augustolnb/Holhooja/projeto-holhooja/docs/obsidian_notes/Pasted image 20240227125910.png

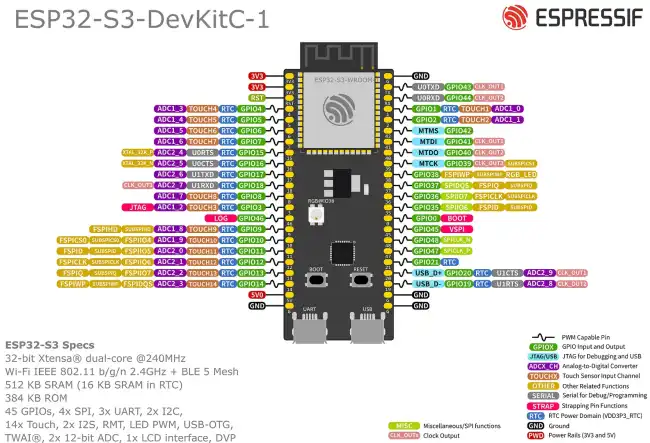
projeto-holhooja/docs/obsidian_notes/Pasted image 20240227125910.png
