augustolnb/Holhooja/projeto-holhooja/docs/obsidian_notes/TCC/Notas diárias/2024-02-22.md

> Link sobre conexão serial:
> https://docs.espressif.com/projects/esp-idf/en/stable/esp32/get-started/establish-serial-connection.html

Bibliotecas instaladas na IDE Arduino:
- PubSubClient
- WifiManager
- EmonLib

### Problema ao fazer upload para o ESP32

> Link da solução:
> https://stackoverflow.com/questions/73923341/unable-to-flash-esp32-the-port-doesnt-exist

Mesmo a IDE do Arduino reconhecendo e mostrando a porta serial em que o esp se encontra conectado, na hora de fazer o upload o monitor de saida apresentava o seguinte erro:

	fatal error occurred: Could not open /dev/ttyACM0, the port doesn't exist

Solução: 

```sh
$ sudo adduser augusto dialout # adiciona o usuario ao grupo dialout
$ sudo chmod a+rw /dev/ttyACM0 # concede permissão de leitura e execução para a porta serial
```

O grupo dialout possui acesso aos dispositivos seriais e *uart drivers* (impressoras, scanner, esp, etc)
