augustolnb/Holhooja/projeto-holhooja/docs/obsidian_notes/TCC/Notas diárias/2024-02-27.md

O formulário de registro voltou a funcionar magicamente 

**amém deux**

- [x] Continuar com a implementação da recuperação de dados do banco para direcionar cada tipo de usuário para sua respectiva pagina.

xikinho da silva | xikito123 | 99999999999 -> usuário comum
ana luzia | bbbolota | 201910101010 -> usuário admin

- Devido a um problema no monitor serial do Arduino IDE, será feita uma tentativa de captura dos códigos ir usando o esp8266 e outro linux ubuntu instalado no notebook DELL.

![[Pasted image 20240227125910.png]]
