augustolnb/Holhooja/projeto-holhooja/docs/obsidian_notes/TCC/Notas diárias/2024-01-02.md

Tentativa de realizar o projeto deste tutorial (https://www.digitalocean.com/community/tutorials/how-to-add-authentication-to-your-app-with-flask-login-pt)

- Primeiro contato com o FLASK. Parece ser simples e fácil de usar.
- A primeira tentativa de projeto consiste em gerar um sistema de autenticação que permite ao usuário logar e acessar um streaming de video
- Há ainda uma dificuldade em criar as tabelas do BD usando o Flask SQLAlchemy, pois aparentemente algum parâmetro esta incorreto.
- Na versão final deverá ser utilizado MariaDB ou similar, mas para fins de testes e aprendizado, será usado SQLite3, como no tutorial.

> Links interessantes:
> 	https://www.tutorialspoint.com/sqlalchemy/sqlalchemy_core_creating_table.htm
> 	https://realpython.com/python-sqlite-sqlalchemy/
> 	https://www.geeksforgeeks.org/sqlalchemy-core-creating-table/
> 	https://docs.sqlalchemy.org/en/20/orm/quickstart.html
