augustolnb/Holhooja/projeto-holhooja/docs/obsidian_notes/TCC/Notas diárias/2024-01-04.md

**Instalação do MariaDB**

Guia de instalação:
https://devopscube.com/install-mariadb-on-ubuntu/

Para remover: 
 ```
 # sudo apt-get purge mariadb-server
 # sudo dpkg -l | grep mariadb
```
