augustolnb/Holhooja/projeto-holhooja/docs/obsidian_notes/TCC/Notas diárias/2024-01-05.md

### Instalando e configurando o MariaDB

> Instalando o mariadb:
```
ATUALIZA OS REPOSITÓRIOS
# sudo apt update

ADICIONA O REPOSITÓRIO OFICIAL DO MARIADB
# curl -LsS https://r.mariadb.com/downloads/mariadb_repo_setup | sudo bash

INSTALA O CLIENTE E O SERVIDOR DO MARIADB
# sudo apt-get install mariadb-server mariadb-client -y
```

> Verifica a versão instalada:
```
# mariadb -V
```

**PS:** o comando *systemctl* é usado para alterar o status do BD
	*# sudo systemctl start mariadb*
	 *# sudo systemctl stop mariadb*
	 *# sudo systemctl restart mariadb*

> Verifica o status do BD
```
# sudo systemctl status mariadb
```
> Configurando o BD de modo seguro
```
# sudo mysql_secure_installation
```
O código a seguir mostra seis questões, sendo elas:
```
Enter current password for root (enter for none): Press enter as there is no password by default.
Set root password? [Y/n]: Select Y and enter a new password.
Remove anonymous users? [Y/n]: Y
Disallow root login remotely? [Y/n]: Y
Remove the test database and access to it? [Y/n]: Y
Reload privilege tables now? [Y/n]: Y
```
> Conectando o BD
```
# mariadb -u root -p
```

Por padrão o MariaDB aceita apenas conexões via socket e via locahost, para conectar clientes remotos é preciso configurar alguns arquivos.
```
# ss - nlt
```

Para habilitar as conexões remotas, vamos configurar o arquivo:

```
# sudo vi /etc/mysql/mariadb.conf.d/50-server.cnf
```
E substituir o *bind-address* para 0.0.0.0
```
bind-address = 0.0.0.0
```
Então reiniciamos o BD:
```
# sudo systemctl restart mariadb
```

### Configurando o MariaDB para acesso de clientes remotos (versão do site oficial)

> Para encontrar a localização dos arquivos:

```
# mariadb --help --verbose
```

Saída do comando:

```
mariadb from 11.2.2-MariaDB, client 15.2 for debian-linux-gnu (x86_64) using  EditLine wrapper
Copyright (c) 2000, 2018, Oracle, MariaDB Corporation Ab and others.

Usage: mariadb [OPTIONS] [database]

Default options are read from the following files in the given order:
/etc/my.cnf /etc/mysql/my.cnf ~/.my.cnf 
```

A última linha revela o caminho dos arquivos de configuração

```
/etc/my.cnf /etc/mysql/my.cnf ~/.my.cnf 
```

Uma vez identificado o caminho dos arquivos, abra-os em um editor de texto e encontre o trecho *[mysqld]* e adicione os seguintes comandos no arquivo .my.cnf (repare que o nome do arquivo começa com um ponto) no seu diretório home ou, em alternativa, no seu arquivo /etc/mysql/my.cnf
*PS: o caminho do arquivo pode mudar*

```
[mysqld]
skip-networking=0
skip-bind-address
```

> Verificar as opções do MariaDB execute

```
# mariadbd --print-defaults
```
### Permitindo conexões de usuários de hosts remotos

*Os usuários no MariaDB são definidos como 'user'@'host', por isso 'chadmaynard'@'localhost' e 'chadmaynard'@'1.1.1.1' (ou 'chadmaynard'@'server.domain.local') são usuários diferentes que podem ter permissões e/ou senhas completamente diferentes*

> Para visualizar os usuários remotos

```
SELECT User, Host FROM mysql.user WHERE Host <> 'localhost';
```

> Para criar um usuário.

```
GRANT ALL ON appdb.* to 'dbadmin'@'192.168.6.6' IDENTIFIED BY 'myPassword';
```

Ou

```
GRANT ALL PRIVILEGES ON *.* TO 'root'@'192.168.100.%' IDENTIFIED BY 'admin' WITH GRANT OPTION;
```

- *"bdadmin"* é o nome de usuário;
- *"appdb"* é o nome do banco de dados.

*O símbolo % é uma representação genérica e pode ser substituído pelo endereço do host, caso contrário, o sinal servirá como um curinga.*

Um outro ponto a considerar é se a firewall está configurada para permitir a entrada de pedidos de clientes remotos:

> Configurar porta 3306 no Firewall

```
INSTALA O UTILITÁTIO 
# sudo apt install firewalld

# firewall-cmd --add-port=3306/tcp 

# firewall-cmd --permanent --add-port=3306/tcp
```

### ***Comandos úteis:***

Selecionar BD
```
mariadb > USE database_name;
```

Mostra tabelas
```
mariadb > SHOW TABLES;
```

Mostra todo o conteúdo de uma tabela
```
mariadb > SELECT * FROM table_name;
```

Mostra os bancos de dados
```
mariadb > SHOW DATABASES;
```

Cria uma tabela
```
mariadb > CREATE TABLE IF NOT EXISTS example_table (
    id INT AUTO_INCREMENT,
    name VARCHAR(255) NOT NULL,
    email VARCHAR(255) NOT NULL,
    age INT,
    PRIMARY KEY (id)
    );
```

Adiciona linhas em uma tabela já existente
```
mariadb > INSERT INTO table_name (name, email, age) VALUES ('John Doe', 'john.doe@example.com', 30);
```

**Tutorial MariaDB:** http://underpop.online.fr/m/mysql/manual/mysql-reference-create-table.html
