augustolnb/Holhooja/projeto-holhooja/docs/obsidian_notes/TCC/Notas diárias/2024-02-26.md

Criação da página de recuperação de senha, porém ainda sem funcionalidades

Implementar a recuperação de dados do banco para direcionar cada tipo de usuário para sua respectiva pagina.
	Usuários tipo 1 (comum) -> confirmação de login e logout
	Usuário tipo 2 (administrador) -> dashboard 

Por algum motivo o trecho 
```python
if form.validate_on_submit():

	hashed_password = bcrypt.generate_password_hash(form.password.data)
	
	new_user = User(nome_completo=form.nome_completo.data, matricula=form.matricula.data, password=hashed_password, email=form.email.data, curso=form.curso.data)
	
	db.session.add(new_user)
	
	db.session.commit()
	
	return redirect(url_for('login'))
```
 presente na tela de solicitação de acesso, passou a ser ignorado, ou seja, ao clicar em enviar as informações para o banco, o servidor retorna a mesma pagina, ignorando totalmente o trecho _if form.validate_on_submit():_
