augustolnb/Holhooja/projeto-holhooja/docs/obsidian_notes/Pasted image 20240228133339.png

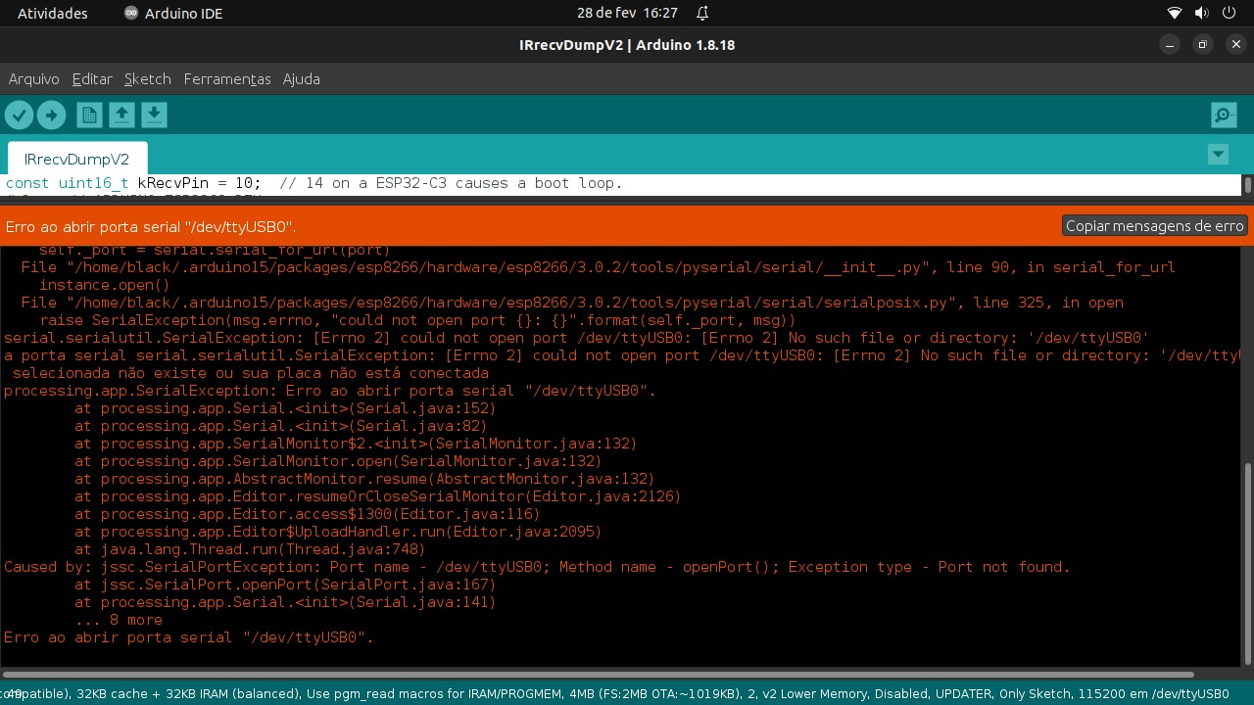
projeto-holhooja/docs/obsidian_notes/Pasted image 20240228133339.png
