augustolnb/Holhooja/(commit log)

2023-03-26 The flower identification problem implemented using different Machine Learning algorithms
2023-04-27 Calcula: Resistência equivalente da malha , Potencial de toque e Potencial de passo para malhas retangulares
2024-03-14 V3.0
    Atualizações:
    - Interface utilizando framework Bulma
    - Página de Admin atualizada
    - Ainda sem consumir da API
    [pyvenv.cfg]
2024-03-20 20/03
    - Login e registro ok
    - Ao fazer login registra no banco o horario de entrada
    - Nova estrutura de projeto
    - Ainda há a necessidade de modular o código app.py
2024-03-23 v4.0
    Adicionando consumo do banco de dados na pagina de adm
2024-03-24 V4.5
    > Acessando e atualizando banco de dados
    > Implementada aprovação/reprovação das solicitações de acesso
    > Finalizar detalhes:
    - checar status no momento do login
    - enviar e-mail de confirmação para o usuário aprovado ou reprovado
    - para usuários aprovados enviar uma senha padrão que poderá ser atualizada posteriormente
2024-03-24 V5.0
    - Mudança de senha: usuario comum e adm
    - Responsividade em todas (?) as páginas
    Pendências
    - Mapear as informações trocadas entre páginas e minimizar esse tráfego
    - Modular as funções de cada rota do arquivo principal
    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
2024-03-31 Atualização da ultima usando sqlite
    >> Proximas alterações:
    - Implementar MariaDB
    - Atualizar estrutura de tabelas do BD
    - Reestruturar páginas do projeto segundo documentação Obsidian
    [pyvenv.cfg]
2024-04-18 esp32 firmware backup
2024-06-04 updated
    css bulma update
    solicitações de acesso - ok
    edição do banco de dados - ok
2024-06-08 updated
    Comunicação esp32 <-> app OK
2025-06-05 up
    Uma breve descrição para detalhar um pouco mais a documentação.
2025-07-28 documentacao
    doc inicial
    - estrutura ok
    - checar markdown
    [pyvenv.cfg]
